fcjr/ch32-pico/hardware/review/README.md

# ch32-pico layout checkpoint

Open [ch32-pico.kicad_pcb](ch32-pico.kicad_pcb) in KiCad 10.0.6.
The local footprint table points to the vendored library.

The [validation report](validation.json) records the source checks, DRC,
connectivity, routing comparison and outstanding prototype work.
Layer previews: [front](front.svg), [back](back.svg),
[ground](ground.svg), [inner power/signals](power.svg).

See [build instructions](../../docs/build.md) for regenerating this checkpoint
and [manufacturing](../../docs/manufacturing.md) for fabrication outputs.
