fcjr/ch32-pico/docs/images/ch32-pico-back.png

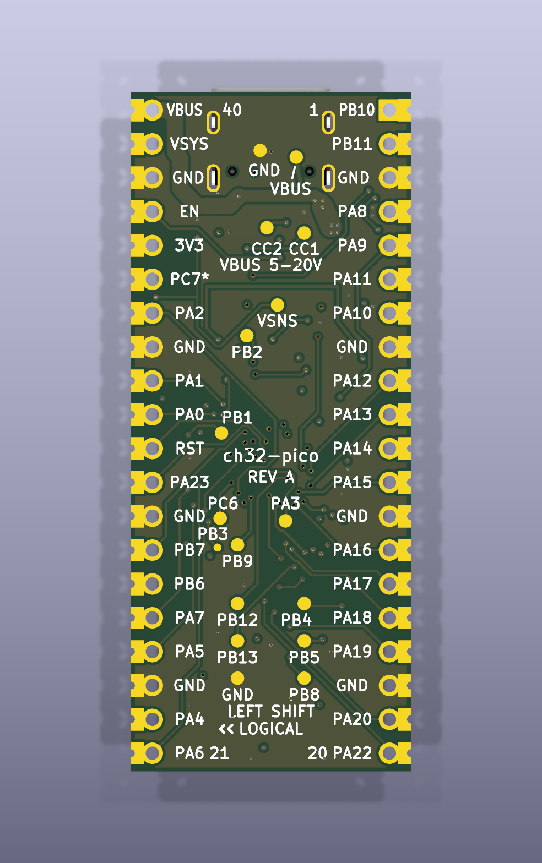
docs/images/ch32-pico-back.png
