fcjr/ch32-pico/docs/images/ch32-pico-front.png

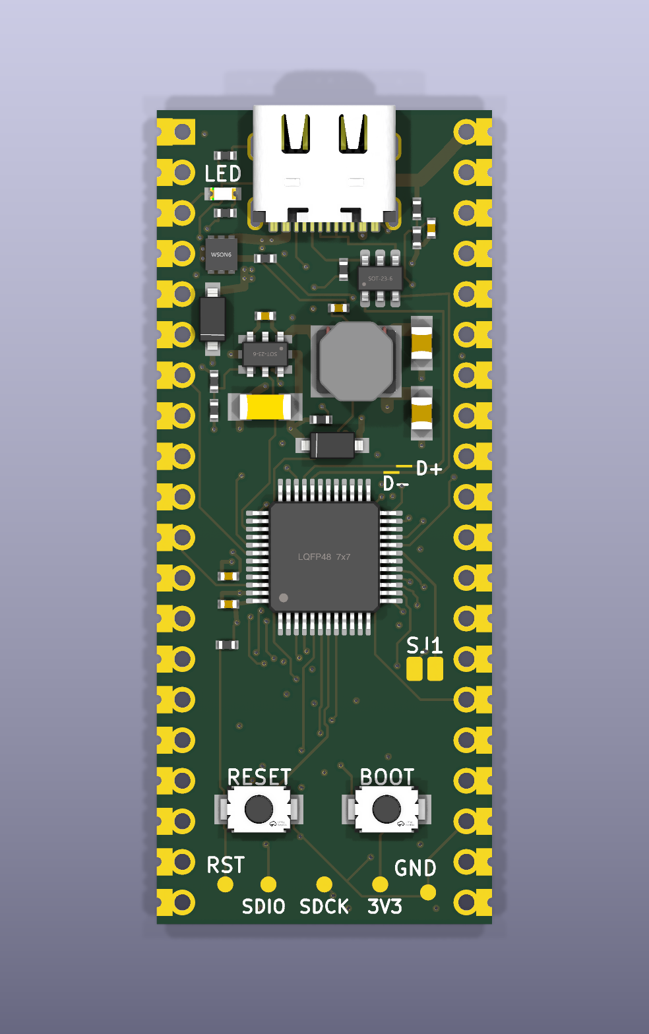
docs/images/ch32-pico-front.png
