fcjr/ch32-pico/hardware/review/jlc-impedance.png

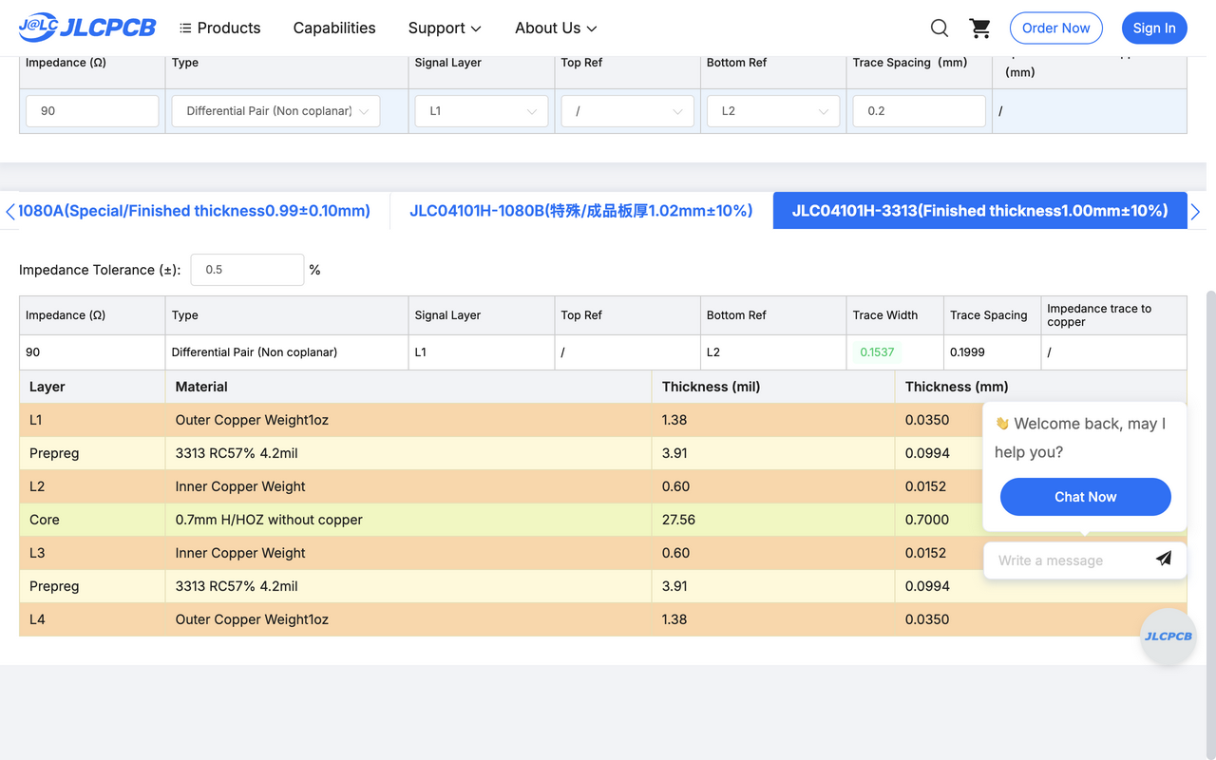
hardware/review/jlc-impedance.png
