fcjr/ch32-pico/hardware/review/ch32-pico.kicad_pcb

## KiCad design hardware/review/ch32-pico.kicad_pcb (2026-10-19)

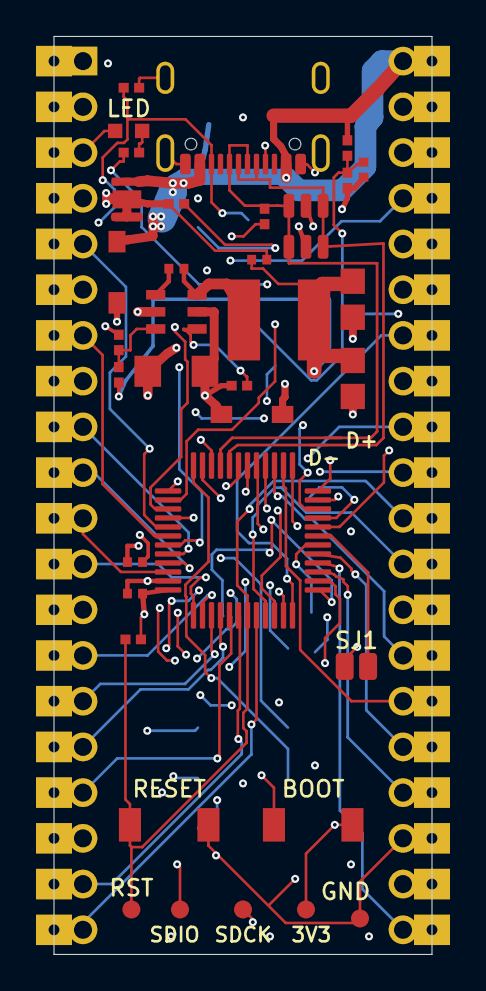
[picture p5: board ch32-pico.kicad_pcb from above]

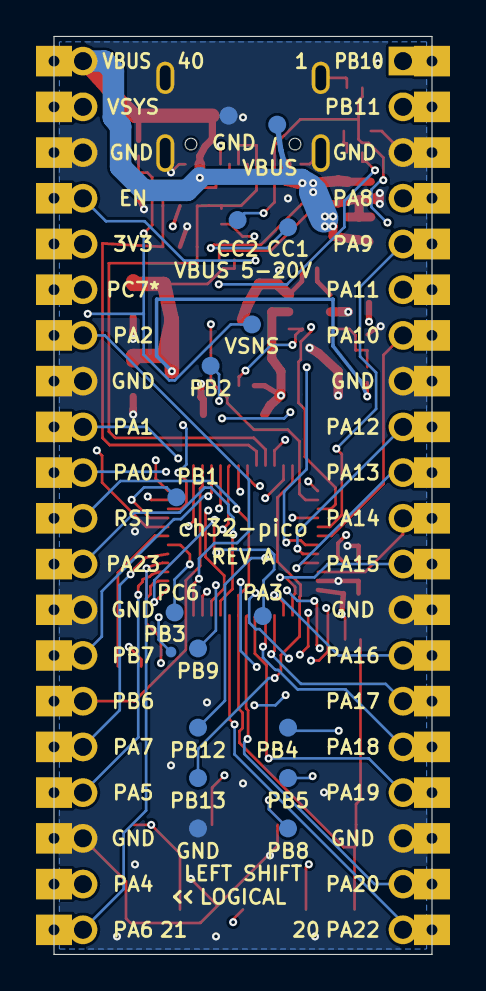
[picture p6: board ch32-pico.kicad_pcb from below]

Board: 4 copper layers, 21.0 x 51.0 mm, 55 parts (17 on the bottom side), 58 nets.

Parts:
C1: 10uF / 50V; C1206
C2, C3: 22uF / 10V; C0805
C4, C6, C9, C11: 100nF / 50V; C0402
C7: 1uF; C0402
D1, D4: B5819W; SOD-123_L2.7-W1.6-LS3.7-RD-1
D2: USBLC6-2SC6; SOT-23-6
D3: RED / STATUS; LED-SMD_L1.6-W0.8-R-RD
D5: TVS2200DRVR; WSON-6_L2.0-W2.0-P0.65-BL-EP
J1: PICO 40-PIN; Pico_Header
J2: GT-USB-7010ASV; USB_C_Receptacle_G-Switch_GT-USB-7010
L1: 4.7uH; IND-SMD_L5.0-W5.0-P3.60_SMNR5040
R1, R15: 100k; R0402
R2, R10: 10k; R0402
R3, R4: 5.1k; R0402
R11: 1k; R0402
R12: 4.7k; R0402
R13: 47k; R0402
R14: 15k; R0402
SJ1: PC7 OPTION; SolderJumper_Open
SW1: RESET; SW-SMD_L3.9-W3.0-P4.45
SW2: BOOT; SW-SMD_L3.9-W3.0-P4.45
TP1: SDIO; TestPad_1mm
TP2: SDCK; TestPad_1mm
TP3: 3V3_OUT; TestPad_1mm
TP4, TP13, TP16: GND; TestPad_1mm
TP5: PA21; TestPad_1mm
TP6: PC6; TestPad_1mm
TP7: PB4; TestPad_1mm
TP8: PB5; TestPad_1mm
TP9: PB8; TestPad_1mm
TP10: PB9; TestPad_1mm
TP11: PB12; TestPad_1mm
TP12: PB13; TestPad_1mm
TP14: PA3; TestPad_1mm
TP15: VBUS; TestPad_1mm
TP17: VBUS_SENSE; TestPad_1mm
TP18: PB1; TestPad_1mm
TP19: CC1; TestPad_1mm
TP20: CC2; TestPad_1mm
TP21: PB2; TestPad_1mm
TP22: STATUS_LED; TestPad_0.6mm
TP23: USB_DP; USB_Probe_Inline
TP24: USB_DM; USB_Probe_Inline
U1: CH32X035C8T6; LQFP-48_7x7mm_P0.5mm
U4: SY8301ABC; SOT-23-6_L2.9-W1.6-P0.95-LS2.8-BL

Connections:
3V3_EN: J1.37, R15.2, U4.4
3V3_OUT: C2.1, C3.1, C6.1, C7.1, C11.1, D2.5, J1.36, L1.2, R10.2, R13.1, SW2.2, TP3.1, U1.48
BOOT_PULLUP: R12.2, SW2.1
BUCK_BST: C4.1, U4.1
BUCK_FB: R13.2, R14.1, U4.3
BUCK_SW: C4.2, L1.1, U4.6
CC1: J2.A5, R3.1, TP19.1, U1.38
CC2: J2.B5, R4.1, TP20.1, U1.39
GND: C1.2, C2.2, C3.2, C6.2, C7.2, C9.2, C11.2, D2.2, D3.2, D5.1, D5.2, D5.3, D5.7, J1.3, J1.8, J1.13, J1.18, J1.23, J1.28, J1.33, J1.38, J2.13, J2.14, J2.15, J2.16, J2.A1B12, J2.B1A12, R2.2, R3.2, R4.2, R14.2, SW1.2, TP4.1, TP13.1, TP16.1, U1.47, U4.2
GPIO35: J1.35, SJ1.1
LED_A: D3.1, R11.2
PA0: J1.31, U1.10
PA1: J1.32, U1.11
PA2: J1.34, U1.12
PA3: TP14.1, U1.13
PA4: J1.22, U1.14
PA5: J1.24, U1.15
PA6: J1.21, U1.16
PA7: J1.25, U1.17
PA8: J1.4, U1.40
PA9: J1.5, U1.41
PA10: J1.7, U1.42
PA11: J1.6, U1.43
PA12: J1.9, U1.44
PA13: J1.10, U1.45
PA14: J1.11, U1.46
PA15: J1.12, U1.1
PA16: J1.14, U1.2
PA17: J1.15, U1.3
PA18: J1.16, U1.4
PA19: J1.17, U1.5
PA20: J1.19, U1.6
PA21: J1.30, R10.1, SW1.1, TP5.1, U1.7
PA22: J1.20, U1.8
PA23: J1.29, U1.9
PB1: TP18.1, U1.21
PB2: TP21.1, U1.22
PB4: TP7.1, U1.24
PB5: TP8.1, U1.25
PB6: J1.26, U1.26
PB7: J1.27, U1.27
PB8: TP9.1, U1.28
PB9: TP10.1, U1.29
PB10: J1.1, U1.30
PB11: J1.2, U1.31
PB12: TP11.1, U1.35
PB13: TP12.1, U1.36
PC6: TP6.1, U1.18
PC7: SJ1.2, U1.19
SDCK: TP2.1, U1.37
SDIO: TP1.1, U1.34
STATUS_LED: R11.1, TP22.1, U1.23
USB_DM: D2.3, D2.4, J2.A7, J2.B7, TP24.1, U1.32
USB_DP: D2.1, D2.6, J2.A6, J2.B6, R12.1, TP23.1, U1.33
VBUS: D1.2, D5.4, D5.5, D5.6, J1.40, J2.A4B9, J2.B4A9, R1.1, TP15.1
VBUS_SENSE: C9.1, R1.2, R2.1, TP17.1, U1.20
VIN_SYS: C1.1, D1.1, D4.1, R15.1, U4.5
VSYS: D4.2, J1.39
