fcjr/ch32-pico/hardware/library.py

# SPDX-License-Identifier: MIT
# Copyright (c) 2026 ch32-pico contributors
"""Read exact procurement metadata; assign reviewed electrical pin types.

EasyEDA geometry is a local input, never authoritative for electrical rules.
The schematic generator draws compact symbols from this typed pin model.
"""
from __future__ import annotations

from dataclasses import dataclass
from pathlib import Path
import re
from .sexp import parse, children, one
from copy import deepcopy
from .design import HEADER, TARGET_PINS

ROOT = Path(__file__).resolve().parents[1]
LIBDIR = ROOT / 'hardware/lib'


@dataclass(frozen=True)
class Pin:
    number: str
    name: str
    electrical: str = 'passive'


@dataclass(frozen=True)
class Part:
    code: str
    mpn: str
    manufacturer: str
    footprint: str
    pins: tuple[Pin, ...]
    description: str = ''

    @property
    def voltage_rating_v(self):
        """Vendor metadata, independent of the schematic/BOM value label."""
        match=re.search(r'\b(\d+(?:\.\d+)?)V\b',self.description)
        return float(match[1]) if match else None


def pin_sort(pin):
    return (0,int(pin.number)) if pin.number.isdecimal() else (1,pin.number)


def load_library():
    library = {}
    for s in children(parse((LIBDIR/'ch32-pico.kicad_sym').read_text()),'symbol'):
        props={p[1]:p[2] for p in children(s,'property')}
        code=props['LCSC Part']
        pins=[]
        for sub in children(s,'symbol'):
            for p in children(sub,'pin'):
                number=one(p,'number')[1]
                name=one(p,'name')[1]
                electrical='passive'
                if code=='C29779902':
                    name=next(k for k,v in TARGET_PINS.items() if str(v)==number)
                    electrical='power_in' if number in {'47','48'} else 'input' if number=='7' else 'bidirectional'
                elif code=='C2927130':
                    electrical={'1':'passive','2':'power_in','3':'input','4':'input','5':'power_in','6':'power_out'}[number]
                elif code=='C3662793':
                    electrical={'1':'input','2':'input','3':'open_collector','4':'open_collector','5':'power_in','6':'power_out','7':'passive','8':'power_in','9':'passive','10':'passive'}[number]
                elif code in {'C1850276','C18197523'}:
                    # One output terminal drives ERC; pin 18 is the same die node.
                    electrical='power_in' if number in {'1','2','5','8','25'} else 'power_out' if number=='17' else 'open_collector' if number in {'14','16'} else 'passive'
                elif code=='C2653623':
                    electrical='power_in' if number in {'2','6'} else 'input' if number in {'3','4'} else 'passive'
                elif code in {'C140262','C132788'}:
                    electrical='open_collector' if number in {'1','6'} else 'input' if number in {'3','4'} else 'power_in'
                elif code=='C5187096':
                    electrical='power_in' if number in {'7','9'} else 'input' if number=='4' else 'bidirectional'
                elif code=='C82942':
                    electrical={'1':'power_in','2':'power_in','3':'input',
                                '4':'passive','5':'power_out'}[number]
                elif code=='C7519':
                    name={'1':'IO1','2':'GND','3':'IO2','4':'IO2','5':'VBUS','6':'IO1'}[number]
                    electrical='power_in' if number in {'2','5'} else 'passive'
                pins.append(Pin(number,name,electrical))
        pins=tuple(sorted(pins,key=pin_sort))
        if len(pins)!=len({p.number for p in pins}):
            raise ValueError(f'Duplicate symbol pins: {code}')
        library[code]=Part(code,props['MPN'],props.get('Manufacturer',''),props['Footprint'].split(':')[-1],pins,props.get('ki_description',''))
    library['PICO_HEADER']=Part('','Pico header pads','','Pico_Header',
        tuple(Pin(str(p.number),p.pico.split(' / ')[0]) for p in HEADER))
    library['TESTPAD']=Part('','Test pad','','TestPad_1mm',(Pin('1','TP'),))
    library['SMALL_PROBE']=Part('','Small probe pad','','TestPad_0.6mm',(Pin('1','TP'),))
    library['USB_PROBE']=Part('','Inline USB probe contact','','USB_Probe_Inline',(Pin('1','TP'),))
    library['SOLDER_JUMPER']=Part('','Normally open solder jumper','','SolderJumper_Open',
        (Pin('1','HEADER35'),Pin('2','PC7')))
    library['POWER_FLAG']=Part('','PWR_FLAG','','',(Pin('1','pwr','power_out'),))
    return library


def validate_library(components, library):
    refs=set()
    for c in components:
        if c.ref in refs: raise ValueError(f'Duplicate reference {c.ref}')
        refs.add(c.ref)
        part=library[c.part]
        actual=set(c.nets)
        expected={p.number for p in part.pins}
        if actual!=expected:
            raise ValueError(f'{c.ref}: missing pins {expected-actual}, extra pins {actual-expected}')
        if c.fitted and not part.code.startswith('C'):
            raise ValueError(f'{c.ref}: fitted component without LCSC identifier')
        if part.code:
            fp=parse((LIBDIR/'ch32-pico.pretty'/f'{part.footprint}.kicad_mod').read_text())
            pads={p[1] for p in children(fp,'pad') if p[1]}
            if pads!=expected:
                raise ValueError(f'{c.ref}: footprint pads differ from symbol pins: {pads ^ expected}')
        for pin in part.pins:
            if pin.electrical=='unspecified': raise ValueError(f'{c.ref}.{pin.number} unspecified type')
            if pin.electrical in {'power_in','power_out'} and c.nets[pin.number] is None:
                raise ValueError(f'{c.ref}.{pin.number} supply pin left NC')


def update_board_parts(doc,components):
    """Refresh BOM fields on an unchanged footprint without touching copper."""
    library=load_library();by_ref={c.ref:c for c in components}
    for fp in children(doc,'footprint'):
        props={p[1]:p for p in children(fp,'property')}
        c=by_ref[props['Reference'][2]];part=library[c.part]
        if fp[1].split(':')[-1]!=part.footprint:
            raise ValueError(f'{c.ref}: part change requires a new footprint')
        props['Value'][2]=c.value or part.mpn
        if part.code:
            if 'LCSC Part' not in props:
                field=deepcopy(props['Value']);field[1]='LCSC Part'
                field[:]=[n for n in field if not isinstance(n,list) or n[0]!='uuid']
                if not children(field,'hide'):field.append(parse('(hide yes)'))
                fp.append(field);props['LCSC Part']=field
            props['LCSC Part'][2]=part.code
