fcjr/ch32-pico/hardware/placement.py

# SPDX-License-Identifier: MIT
"""Power beside USB-C and its header pins, MCU centred on the GPIO rows,
paired controls at the bottom; front fitted assembly."""
PLACEMENT = {'SJ1': (16.8, 35.0, 0),
 'J1': (0, 0, 0),
 'J2': (10.5, 3.375, 180),
 'U1': (10.5, 28, 90),
 'U4': (6.8, 15.3, 270),
 'L1': (12.5, 15.75, 0),
 'D1': (3.5, 13.1, 90),
 'D4': (11.0, 21.0, 0),
 'D2': (14, 10.55, 90),
 'D3': (4.15, 5.25, 0),
 'SW1': (6.4, 43.8, 0),
 'SW2': (14.4, 43.8, 0),
 'R1': (16.3, 6.2, 270),
 'R2': (16.3, 8.0, 270),
 'R3': (6.8, 9.3, 180),
 'R4': (4.3, 2.85, 0),
  'R13': (3.6, 18.8, 90),
 'R14': (3.6, 17.0, 90),
 'R15': (10.3, 19.4, 0),
 'R10': (4.4, 33.5, 0),
 'R11': (4.3, 6.45, 0),
 'R12': (11.7, 10, 270),
 'C1': (6.8, 18.6, 180),
 'C2': (16.6, 14.6, 270),
 'C3': (16.6, 19.0, 270),
 'C4': (6.8, 12.9, 0),
 'C6': (4.5, 30.95, 180),
 'C7': (4.5, 29.2, 180),
 'C9': (17.2, 7.4, 270),
 'C11': (11.4, 12.4, 0),
 'TP1': (7, 48.5),
 'TP2': (10.5, 48.5),
 'TP3': (14, 48.5),
 'TP4': (17.0, 49.0),
 'TP5': (4.3, 48.5),
 'TP6': (14.3, 32.0),
 'TP7': (8, 38.4),
 'TP8': (8, 41.2),
 'TP9': (8, 44),
 'TP10': (13, 34),
 'TP11': (13, 38.4),
 'TP12': (13, 41.2),
 'TP13': (13, 44),
 'D5': (4.05, 9.05, 0)}

BACK_REFS = {f'TP{i}' for i in range(6,14)}
from .diagnostics import DIAGNOSTICS
PLACEMENT.update({d.ref:d.position for d in DIAGNOSTICS})
BACK_REFS.update(d.ref for d in DIAGNOSTICS if d.side=='B')
