fcjr/ch32-pico/tests/test_assembly.py

# SPDX-License-Identifier: MIT
# Copyright (c) 2026 ch32-pico contributors
import unittest
from hardware.assembly_checks import via_in_paste
from hardware.sexp import parse


class AssemblyChecks(unittest.TestCase):
    def board(self,x,y):
        return parse(f'''(kicad_pcb
          (footprint "test" (at 10 10 90) (property "Reference" "R1")
            (pad "1" smd rect (at -1 0 90) (size 1 0.5) (layers "F.Cu" "F.Paste")))
          (via (at {x} {y}) (drill 0.2)))''')

    def test_rotated_pad_drill_overlap_rejected(self):
        self.assertEqual(via_in_paste(self.board(10,11))[0]['pad'],'R1.1')

    def test_drill_edge_overlap_rejected(self):
        self.assertTrue(via_in_paste(self.board(10.3,11)))

    def test_escape_via_outside_paste_allowed(self):
        self.assertEqual(via_in_paste(self.board(10.5,11)),[])


class ExposedPadTests(unittest.TestCase):
    def test_paste_window_gap_does_not_allow_ordinary_thermal_via(self):
        doc=parse('''(kicad_pcb
            (footprint "WSON" (at 4 9)
                (property "Reference" "D5")
                (pad "7" smd rect (at 0 0) (size 0.9 1.6) (layers "F.Cu" "F.Mask")))
            (via (at 4 9) (size .45) (drill .2)))''')
        self.assertEqual(via_in_paste(doc)[0]['pad'],'D5.7')
