fcjr/ch32-pico/tests/test_usb_review.py

# SPDX-License-Identifier: MIT
# Copyright (c) 2026 ch32-pico contributors
import unittest
from hardware.sexp import parse,children,one
from hardware.usb_review import contains,path_length


class USBGeometryChecks(unittest.TestCase):
    def test_bridged_ground_cutout_is_not_copper(self):
        # Outer square with a bridge to an inner square, as in KiCad fills.
        polygon=[(0,0),(4,0),(4,4),(0,4),(0,0),
                 (1,1),(1,3),(3,3),(3,1),(1,1),(0,0)]
        self.assertTrue(contains((.5,2),polygon))
        self.assertFalse(contains((2,2),polygon))
        self.assertFalse(contains((5,2),polygon))

    def test_route_length_splits_t_junction(self):
        doc=parse('''(kicad_pcb
          (segment (start 0 0) (end 4 0))
          (segment (start 2 0) (end 2 3)))''')
        self.assertEqual(path_length(children(doc,'segment'),(0,0),(2,3)),5)

    def test_disconnected_centerline_fails(self):
        doc=parse('(kicad_pcb (segment (start 0 0) (end 1 0)))')
        with self.assertRaises(ValueError):path_length(children(doc,'segment'),(0,0),(2,0))


class USBProbeChecks(unittest.TestCase):
    def test_probe_widening_and_displacement_are_rejected(self):
        from copy import deepcopy
        from pathlib import Path
        from hardware.usb_review import probe_contacts, pad_centers, USB_NETS
        original=parse(Path('build/ch32-pico-seed.kicad_pcb').read_text())
        tracks=[t for t in children(original,'segment') if one(t,'net')[-1] in USB_NETS]
        self.assertEqual(len(probe_contacts(original,tracks,pad_centers(original))),2)
        for fault in ('widen','move'):
            with self.subTest(fault=fault):
                doc=deepcopy(original)
                fp=next(f for f in children(doc,'footprint') if any(
                    p[1:3]==['Reference','TP23'] for p in children(f,'property')))
                if fault=='widen':one(one(fp,'pad'),'size')[2]='0.6'
                else:one(fp,'at')[2]='21.9'
                with self.assertRaisesRegex(ValueError,'outside existing trace'):
                    probe_contacts(doc,tracks,pad_centers(doc))
