fcjr/ch32-pico/(commit log)

2026-10-12 prepare public release
    [ch32-pico.kicad_pcb]
2026-10-12 Build CH32X035 Rev B prototype and refresh documentation
    [ch32-pico.kicad_pcb]
2026-10-13 Rework Rev C USB and power placement, add underside GPIO pads
    [ch32-pico.kicad_pcb]
2026-10-13 Review Rev C factory files and refresh consumer README
    [ch32-pico.kicad_pcb]
2026-10-13 Add pin 37 regulator enable control in Rev D
    [ch32-pico.kicad_pcb]
2026-10-13 Expose Rev E diagnostics and build JLCPCB files with uv and just
    [ch32-pico.kicad_pcb]
2026-10-13 Fix power component ratings and assembly placement metadata
    Use verified 50 V bypass capacitors, reduce the nominal eFuse limit to 2.93 A, and validate BOM metadata against the reviewed board. Apply JLC model frame corrections and extend regression coverage.
    Record the parts inventory, exact-MCU sourcing options, and unresolved power qualification requirements. Retain CH32X035C8T6 and its GPIO allocation.
    [ch32-pico.kicad_pcb]
2026-10-15 Reduce Rev E board cost and regroup protected power layout
    Use the four-layer MX26631 power stage, retain Pico castellations and front-side assembly, and group RESET/BOOT controls. Refresh routing checkpoints, component models, silkscreen, and README renders.
    Consolidate precision resistors, add 20/100-board cost scenarios, and reject stale Gerber layers in fabrication exports. Record remaining firmware, sourcing, factory-review, and physical qualification requirements.
    Validation: 96 tests passed; ERC, board/panel DRC, connectivity, placement parity, and four-layer Gerber inventory checked.
    [ch32-pico.kicad_pcb]
2026-10-15 Strengthen capacitor and surge-clamp ground returns
    [ch32-pico.kicad_pcb]
2026-10-18 Feed pin 40 directly from USB VBUS and simplify to a single Rev A design
    Pin 40 now follows USB VBUS like the Pico: 5 V at attach and whatever
    contract firmware negotiates. The eFuse load switch, reverse-blocking FETs,
    undervoltage supervisor, output clamps and current/output sense parts are
    removed; the input TVS clamp stays to protect the regulator from hot-plug
    ringing. Fitted parts drop from 52 to 26 and the parts estimate from $5.69
    to $3.21 per board at 20.
    Layout: the removed parts' copper is pruned from the reviewed board, a
    1.2 mm bottom trunk and a 0.8 mm front feed both reach pin 40 so neither
    connector VBUS pad relies on a single via, redundant front-layer ground
    links between t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
    [ch32-pico.kicad_pcb]
2026-10-18 Move the regulator under USB-C and centre the MCU
    The 3.3 V buck, its diode-OR inputs and the VBUS sense divider now sit in
    the band directly below the connector, beside header pins 36, 37 and 39
    that they serve, instead of mid-board where the removed load switch used
    to leave room for them. The MCU moves to the fanout's reference position
    at y = 28 mm so both header columns and the USB pair reach it with similar
    lengths, with decoupling and the reset pull-up following it. SJ1 and the
    USB probe contacts move with the shortened USB tail.
    The board is rerouted from the new seed with the pinned Freerouting run;
    a locked back-layer feed reaches the VBUS probe pad that routers strand in
    the grou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
    [ch32-pico.kicad_pcb]
2026-10-19 Lock a 3.3 V supply trunk, widen VSYS and stitch the back pour
    The 3.3 V inner pour was split into islands by signal routing and the MCU's
    island hung off 0.15 mm router taps. A locked 0.6 mm trunk on the supply
    layer now joins the regulator output to a via at the MCU decoupling
    capacitor and to header pin 36, and the rerouted pour is one polygon. VSYS
    runs at 0.4 mm. The stitch planner may now place vias through the wide part
    of the 3.3 V pour, so 17 grid vias keep every point of the back pour within
    6 mm of a ground via or pin. Rerouted with the pinned Freerouting run; DRC,
    connectivity, geometry audits, tests, patch, bundle and renders regenerated.
    [ch32-pico.kicad_pcb]
2026-10-19 Describe the current placement and routing checks in the README
2026-10-19 Rewrite the README for people using the board
2026-10-19 Move SJ1 to the front, switch to the Basic tactile switch and refresh stock
    The PC7 solder jumper now sits on the front beside the right header row
    below the MCU, where it can be bridged without flipping the board; the
    silkscreen audit and docs follow it. The board is rerouted with the pinned
    Freerouting run, re-stitched and re-reviewed with DRC and connectivity clean.
    RESET and BOOT use XUNPU TS-1088-AR02016 (C720477), a JLC Basic part with
    the same land pattern as the 2.5 mm variant that showed no stock at order
    time. The JLC procurement snapshot is refreshed: every fitted part now shows
    stock for the batch, including the CH32X035 that was previously short, and
    the parts estimate is $3.17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
    [ch32-pico.kicad_pcb]
2026-10-19 Replace the AP63203 with a Silergy SY8301 buck
    U4 is now the SY8301ABC: 4.5-40 V input, 1 A, 2 MHz, 22 uA quiescent, at
    $0.18 instead of $1.06 at this quantity. R13/R14 (47k/15k) set 3.31 V from
    its 0.8 V reference, with the top resistor sensing the output capacitors over
    a dedicated bottom-layer trace that the shared pour must not bypass. R15
    pulls EN up to the diode-OR node so VSYS-only power still starts the
    regulator while header pin 37 grounds it. The inductor, bootstrap and bulk
    capacitors are unchanged.
    The SOT-23-6 pin order differs from the AP63203, so the cluster is re-laid
    out: bootstrap capacitor above the IC, input capacitor below with ground
    vias beside both it and the IC grou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
    [ch32-pico.kicad_pcb]
2026-10-19 Use the hanxia 4x3 mm tactile switch for RESET and BOOT
    Both XUNPU TS-1088 variants showed no stock on the JLC order page while the
    catalogue reported stock, so SW1/SW2 move to hanxia HX 3x4x2-2P-1.6N
    (C49234124, 197k reported). Its 1.3 x 1.7 mm pads at +/-2.16 mm fall
    within the reviewed two-pad land pattern, so no copper changes; the symbol,
    render model, procurement snapshot, switch research record, stock table and
    cost figures follow. Parts are $2.30 per board at 20.
    [ch32-pico.kicad_pcb]
2026-10-19 Use the GT-USB-7010ASV USB-C receptacle
    The AW variant showed no stock at order time. The ASV (C2988369, 117k
    reported, 3 A contacts) is the part our land pattern was drawn from, so the
    copper is unchanged; the footprint takes the family name, and the 5 A AN
    variant is the approved substitute. The symbol, model frame offset, render
    model, mechanical check, procurement snapshot, stock table and cost figures
    follow: parts are $2.15 per board at 20.
    [ch32-pico.kicad_pcb]
2026-10-19 Space the buck output caps off the inductor and reroute
    Move C2/C3, C11, D1 and D5 so every fitted courtyard keeps at least 0.2 mm
    from its neighbours, and add a courtyard-gap check to placement
    verification. Reroute the board, re-plan the ground stitch grid and refresh
    the review checkpoint, renders and fabrication outputs.
    [ch32-pico.kicad_pcb]
2026-10-19 Rebuild footprint courtyards and re-space the buck output stage
    The EasyEDA-imported footprints drew the package body on the courtyard
    layer, so KiCad's courtyard check and the placement gate never saw pad
    overlaps; the buck output capacitors actually overlapped the inductor pad.
    Draw real courtyards (pads and body plus 0.25 mm, 0.15 mm for 0402) in the
    vendoring script, reject any overlap, and re-space the parts the new check
    caught: output caps turned vertical beside the inductor with a locked feed
    and dedicated ground vias, input cap, sense divider, feedback resistors,
    input diode, LED and its resistor.
    Lock an inner-layer link from the 3.3 V trunk to the ESD diode supply so the
    router n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
    [ch32-pico.kicad_pcb]
2026-10-19 Align the corner header legends with their rows
    Put the names for pins 1, 20, 21 and 40 beside their pads like every other
    row and place the pin numbers just inward of them, past the USB shell stakes
    at the top. The two names beside the stakes use condensed 0.7 mm wide type
    to keep 0.3 mm from the pads. Drop the bracket leaders that reached around
    the stakes.
    [ch32-pico.kicad_pcb]
